Alexandr-Filatov/PSFB_PrimarySyde/BOM/PSFB_PrimarySide_BOM_08.06.2026_EN.xlsx

Reference | Value | Product Name | Replacement | Package | Description | Quantity | DNP
C5, C15, C24, C33, C40, C41, C42, C43, C44, C45, C46, C47, C48, C53 | 100n |  |  | SMD 0805 | Capacitor SMD 50V | 14
C14, C30 | 100n | C1812X104K102T |  | SMD 1812 | Capacitor Film | 2
C49 | 10u | CA45-A010K106T |  | CP EIA-3216-18 Kemet-A | Capacitor Tantalum SMD | 1
C50 | 10u |  |  | SMD 1206 | Capacitor SMD 50V | 1
C9, C10, C17, C18, C26, C27, C35, C36 | 10u |  |  | SMD 1210 | Capacitor SMD 50V | 8
C12, C19, C28, C37 | 22p |  |  | SMD 0805 | Capacitor SMD 50V | 4
C3 | 22u | CA45-A010K226T |  | CP EIA-3216-18 Kemet-A | Capacitor Tantalum SMD | 1
C1, C2, C4, C7, C13, C16, C22, C23, C25, C31, C32, C34 | 56p |  |  | SMD 0805 | Capacitor SMD 50V | 12
C6, C8 | 5u | B32774D8505K000 |  | Rect L31.5mm W15.0mm P27.50mm MKS4 | Capacitor Film | 2
C11, C20, C29, C38 | ~ |  |  | SMD 0805 | Capacitor SMD 50V | 4
D2 | ~ | K7805-500R3 |  | K78xx-500R3 ÕýÊä³ö | Linear regulator | 1
D10, D14, D18, D22 | ~ | US1M |  | SMA | Ultrafast diode | 4
D4, D23, D25, D27 | ~ | FYLS-0805UBC |  | SMD 0805 | LEDs | 4
D3, D6, D24, D26 | ~ | FYLS-0805URC |  | SMD 0805 | LEDs | 4
D5, D28 | ~ | FYLS-0805UYC |  | SMD 0805 | LEDs | 2
D32, D33, D34, D35 | ~ | MS2111 |  | SO-8 3.9x4.9mm P1.27mm | LVDS | 4
D8, D12, D16, D20 | ~ | MMSZ5240B |  | SOD-123 | Zener diode | 4
D9, D13, D17, D21 | ~ | BZT52C2V4S |  | SOD-323 | Zener diode | 4
D1 | ~ | 74HC21 |  | SOIC-14 3.9x8.7mm P1.27mm | AND | 1
D7, D11, D15, D19 | ~ | NSI6651ASC-DSWR |  | SOIC-16W 7.5x10.3mm P1.27mm | Gate Driver | 4
J10 | ~ | FH12-20S-0.5SH |  | Hirose FH12-20S-0.5SH 1x20-1MP P0.50mm | Connector | 1
J5, J6, J7, J8, J9, J12 | ~ | KLS1-208-2-04-S |  | PinSocket 2x02 P2.54mm | Connector | 6
Q5 | ~ | BC817 |  | SOT-23 | Bipolar transistor | 1
Q1, Q2, Q3, Q4 | ~ | C3M0065100K |  | TO-247-4 | SiC Mosfet | 4
R10, R14, R21, R28 | 10 |  |  | SMD 1206 | Resistor SMD | 4
R13, R16, R23, R30, R39, R40, R41, R42 | 100 |  |  | SMD 0805 | Resistor SMD | 8
R8, R17, R24, R31 | 10k |  |  | SMD 0805 | Resistor SMD | 4
R7, R12, R20, R27 | 120 |  |  | SMD 0805 | Resistor SMD | 4
R1, R2, R3, R4, R5, R9, R18, R19, R25, R26, R32, R33, R34, R35, R36, R37, R38, R101 | 1k |  |  | SMD 0805 | Resistor SMD | 18
R11, R15, R22, R29 | 2.2 |  |  | SMD 1206 | Resistor SMD | 4
R6 | 3k |  |  | SMD 0805 | Resistor SMD | 1
R100 | 4.7k |  |  | SMD 0805 | Resistor SMD | 1
U5 | ~ | AMS1117-3.3 |  | SOT-223-3 | Linear regulator | 1
U6, U7, U8, U9 | ~ | USBLC6-2SC6 |  | SOT-23-6 | ESD protection | 4
U1, U2, U3, U4 | ~ | 74LVC1G08 |  | SOT-353 SC-70-5 | AND | 4
