Alexandr-Filatov/PSFB_PrimarySyde/PSFB_Supply/BOM/PSFB_Supply_BOM_15.07.2026_EN.xlsx

Reference | Value | Product Name | Replacement | Package | Description | Quantity | DNP
C3, C8, C13, C18 | 100p |  |  | SMD 1206 | Capacitor SMD 50V | 4
C4, C5, C9, C10, C14, C15, C19, C20 | 10u |  |  | SMD 1206 | Capacitor SMD 50V | 8
C1, C2, C6, C7, C11, C12, C16, C17 | 4.7u |  |  | SMD 1206 | Capacitor SMD 50V | 8
D1, D2, D3, D4 | ~ | QA151C3 |  | QA01 | DC/DC | 4
J1, J2, J3, J4, J5, J6 | ~ | KLS1-207-2-04-S |  | PinHeader 2x02 P2.54mm | Connector | 6
L1, L2, L3, L4 | 22u | CDRH5D28NP-220NC |  | Bourns-SRN6028 | Inductor SMD | 4
