Alexandr-Filatov/PSFB_PrimarySyde/3D/PSFB_Primary_Syde_v1.0_light.step

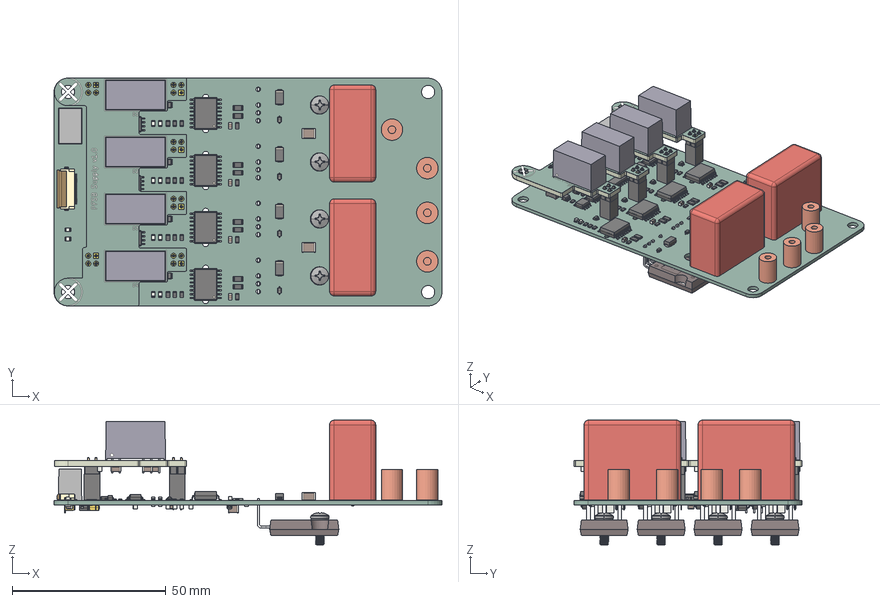
[picture p1: CAD file, 2026-08-03]
3D/PSFB_Primary_Syde_v1.0_light.step
126.0 x 74.0 x 40.5 mm
PinSocket_2x02_P2.54mm_Vertical x 6
C_0805_2012Metric x 30
R_0805_2012Metric x 36
LED_0805_2012Metric x 10
R_1206_3216Metric x 8
SOT-353_SC-70-5 x 4
D_SOD-323 x 4
K78-500-SHELL_3_1
PRT0001_1 x 3
SOT-23
PIN_1_1_1 x 20
PinHeader_2x02_P2.54mm_Vertical x 6
C_1206_3216Metric x 21
PSFB_Supply_copper
PSFB_Supply_silkscreen x 2
PSFB_Supply_soldermask x 2
PSFB_Supply_PCB
SOT-23-6 x 4
C_Rect_L31.5mm_W15.0mm_P27.50mm_MKS4 x 2
SO-8_3.9x4.9mm_P1.27mm x 4
D_SMA x 4
Bush_Phase x 4
SOIC-16W_7.5x10.3mm_P1.27mm x 4
C_1812_4532Metric x 2
SOIC-14_3.9x8.7mm_P1.27mm
lock
pins
D_SOD-123 x 4
C_1210_3225Metric x 8
CP_EIA-3216-18_Kemet-A x 2
SOT-223
PSFB_PrimarySide_PCB
