Alexandr-Filatov/PSFB_PrimarySyde/3D/Bush_Phase.stp

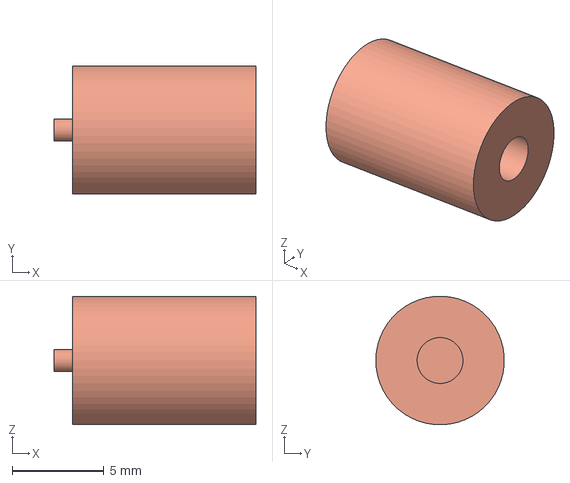
[picture p2: CAD file, 2026-08-03]
3D/Bush_Phase.stp
11.0 x 6.99 x 7.00 mm
