Alexandr-Filatov/PSFB_PrimarySyde/3D/PSFB_Supply_v1.0.step

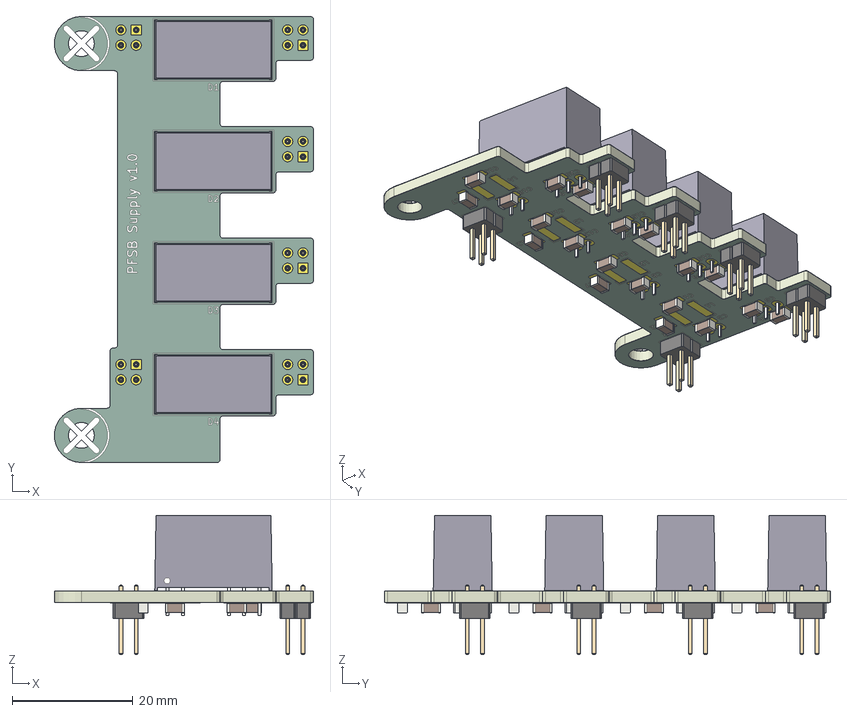
[picture p3: CAD file, 2026-05-29]
3D/PSFB_Supply_v1.0.step
43.0 x 74.0 x 23.1 mm
PIN_1_1_1 x 20
PinHeader_2x02_P2.54mm_Vertical x 6
C_1206_3216Metric x 20
PSFB_Supply_copper
PSFB_Supply_silkscreen x 2
PSFB_Supply_soldermask x 2
PSFB_Supply_PCB
