Alexandr-Filatov/PSFB_PrimarySyde/3D/1-215079-4.stp

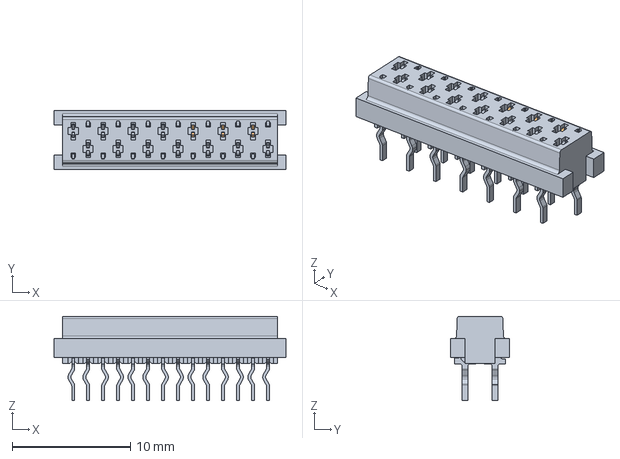
[picture p4: CAD file, 2026-05-27]
3D/1-215079-4.stp
19.7 x 5.00 x 7.15 mm
