Alexandr-Filatov/PSFB_PrimarySyde/3D/K78xx-1000R3.stp

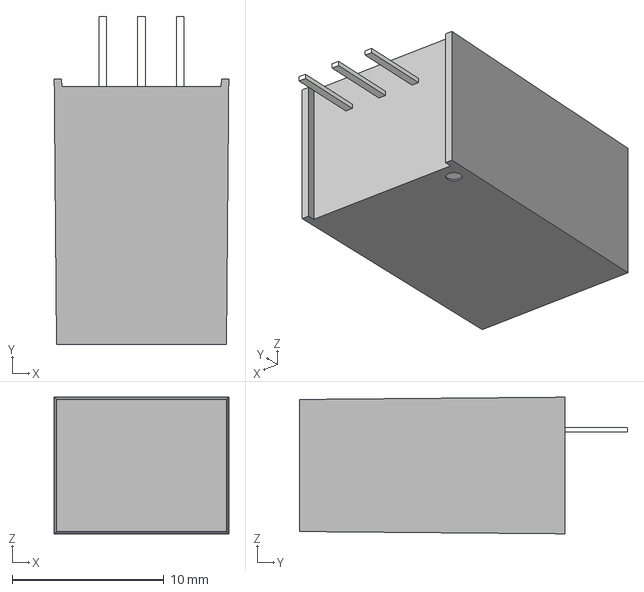
[picture p5: CAD file, 2026-05-27]
3D/K78xx-1000R3.stp
11.5 x 21.6 x 9.00 mm
K78-1000_1
PRT0001_1 x 3
