Alexandr-Filatov/PSFB_PrimarySyde/3D/QA01.stp

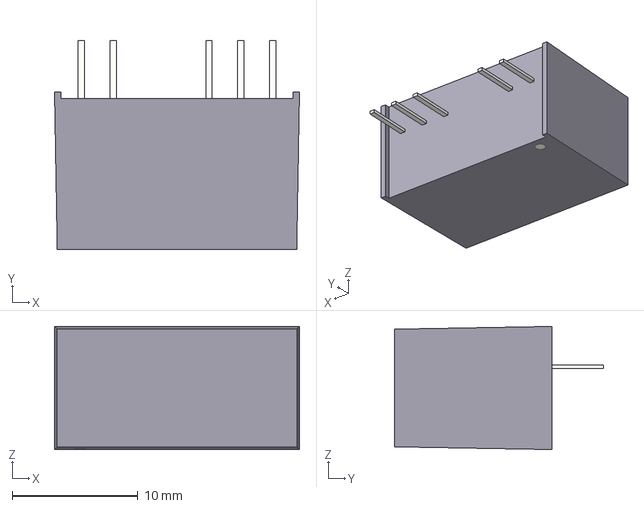
[picture p6: CAD file, 2026-05-25]
3D/QA01.stp
19.5 x 16.6 x 9.80 mm
PIN_1_1_1 x 5
