Alexandr-Filatov/PSFB_PrimarySyde/3D/70085998.stp

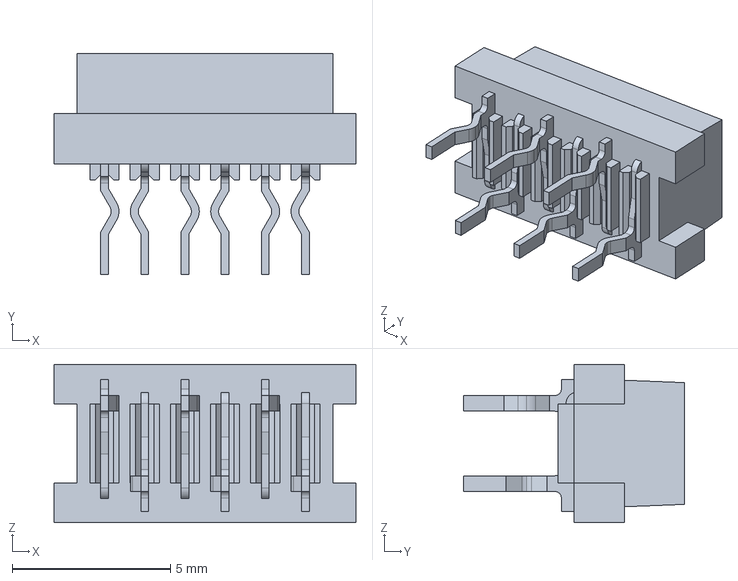
[picture p7: CAD file, 2026-05-27]
3D/70085998.stp
9.55 x 7.00 x 5.00 mm
