Alexandr-Filatov/PSFB_PrimarySyde/3D/TO-247-4LD bend top + M3 screw.stp

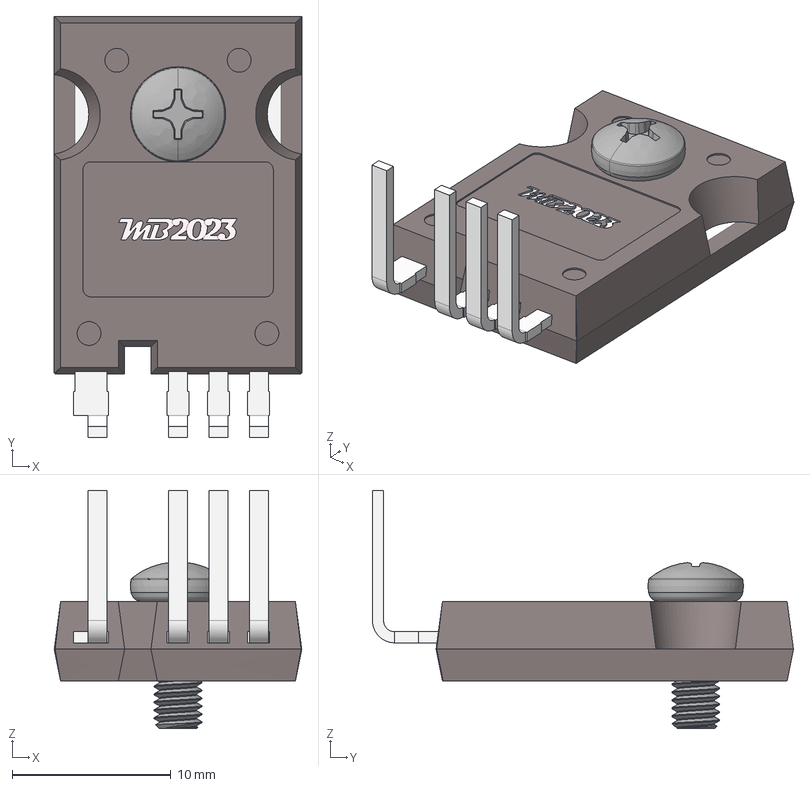
[picture p9: CAD file, 2026-05-26]
3D/TO-247-4LD bend top + M3 screw.stp
15.6 x 26.5 x 15.0 mm
