Alexandr-Filatov/PSFB_PrimarySyde/PSFB_PrimarySide.kicad_pcb

## KiCad design PSFB_PrimarySide.kicad_pcb (2026-08-03)

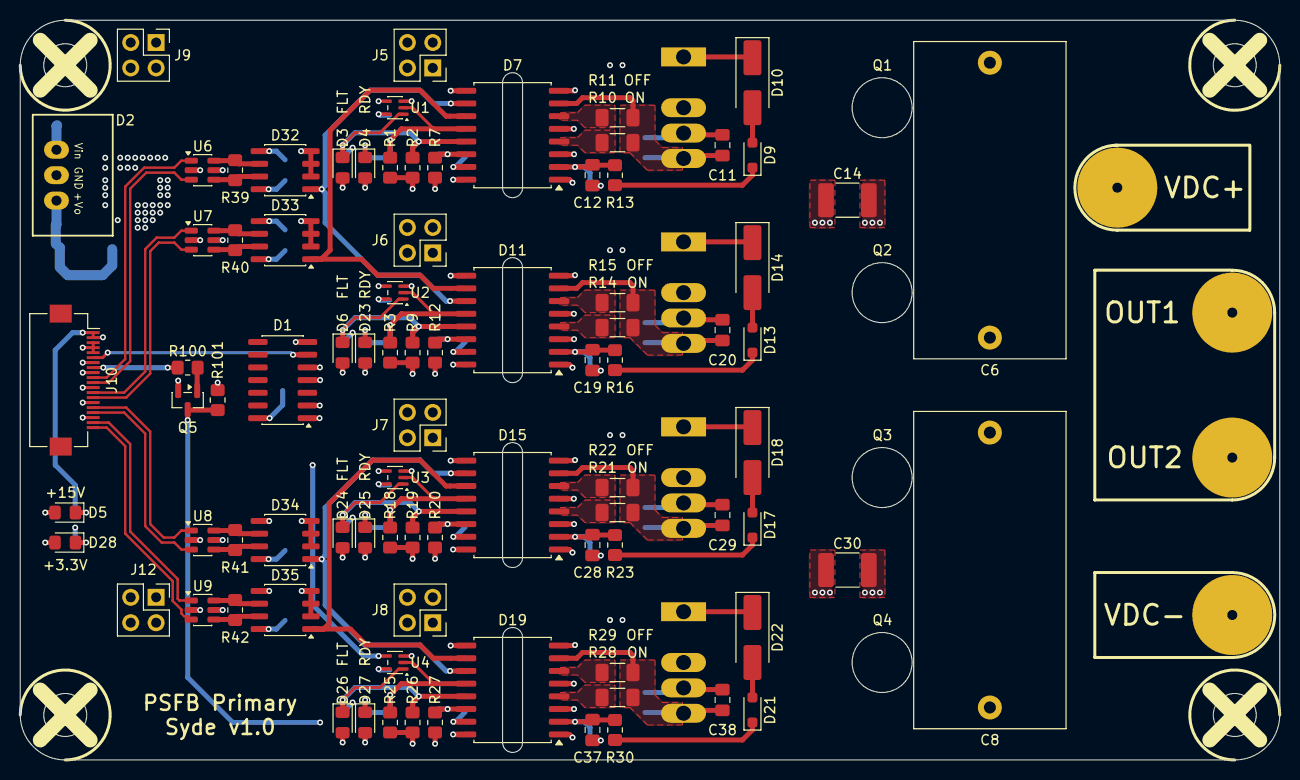
[picture p10: board PSFB_PrimarySide.kicad_pcb from above]

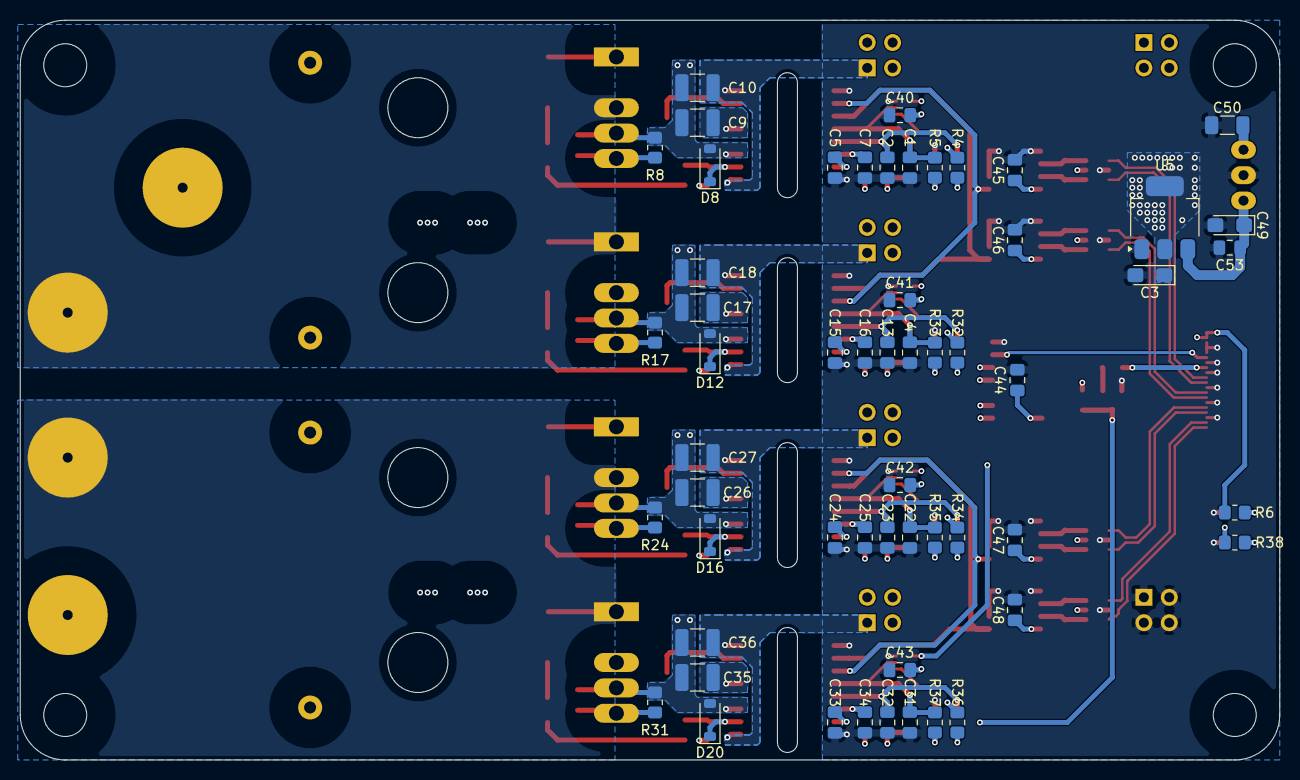
[picture p11: board PSFB_PrimarySide.kicad_pcb from below]

Board: 4 copper layers, 126.0 x 74.0 mm, 154 parts (56 on the bottom side), 90 nets.

Parts:
C1, C2, C4, C7, C13, C16, C22, C23, C25, C31, C32, C34: 56p; C_0805_2012Metric_Pad1.18x1.45mm_HandSolder
C3: 22u; CP_EIA-3216-18_Kemet-A_HandSolder
C5, C15, C24, C33, C40, C41, C42, C43, C44, C45, C46, C47, C48, C53: 100n; C_0805_2012Metric_Pad1.18x1.45mm_HandSolder
C6, C8: 5u; C_Rect_L31.5mm_W15.0mm_P27.50mm_MKS4
C9, C10, C17, C18, C26, C27, C35, C36: 10u; C_1210_3225Metric_Pad1.33x2.70mm_HandSolder
C11, C20, C29, C38: C_0805_2012Metric_Pad1.18x1.45mm_HandSolder
C12, C19, C28, C37: 22p; C_0805_2012Metric_Pad1.18x1.45mm_HandSolder
C14, C30: 100n; C_1812_4532Metric_Pad1.57x3.40mm_HandSolder
C49: 10u; CP_EIA-3216-18_Kemet-A_HandSolder
C50: 10u; C_1206_3216Metric_Pad1.33x1.80mm_HandSolder
D1: SOIC-14_3.9x8.7mm_P1.27mm
D2: K78xx-500R3 ÕýÊä³ö
D3, D4, D5, D6, D23, D24, D25, D26, D27, D28: LED_0805_2012Metric_Pad1.15x1.40mm_HandSolder
D7, D11, D15, D19: SOIC-16W_7.5x10.3mm_P1.27mm
D8, D12, D16, D20: D_SOD-123
D9, D13, D17, D21: D_SOD-323_HandSoldering
D10, D14, D18, D22: D_SMA_Handsoldering
D32, D33, D34, D35: SO-8_3.9x4.9mm_P1.27mm
H1, H2, H3, H4: MountingHole_4.3mm_M4
J1: DC+; Bush_1x8
J2: DC-; Bush_1x8
J3: OUT1; Bush_1x8
J4: OUT2; Bush_1x8
J5, J6, J7, J8, J9, J12: PinSocket_2x02_P2.54mm_Vertical
J10: Hirose_FH12-20S-0.5SH_1x20-1MP_P0.50mm_Horizontal
Q1, Q2, Q3, Q4: TO-247-4_Horizontal_TabDown
Q5: SOT-23
R1, R2, R3, R4, R5, R9, R18, R19, R25, R26, R32, R33, R34, R35, R36, R37, R38, R101: 1k; R_0805_2012Metric_Pad1.20x1.40mm_HandSolder
R6: 3k; R_0805_2012Metric_Pad1.20x1.40mm_HandSolder
R7, R12, R20, R27: 120; R_0805_2012Metric_Pad1.20x1.40mm_HandSolder
R8, R17, R24, R31: 10k; R_0805_2012Metric_Pad1.20x1.40mm_HandSolder
R10, R14, R21, R28: 10; R_1206_3216Metric_Pad1.30x1.75mm_HandSolder
R11, R15, R22, R29: 2.2; R_1206_3216Metric_Pad1.30x1.75mm_HandSolder
R13, R16, R23, R30, R39, R40, R41, R42: 100; R_0805_2012Metric_Pad1.20x1.40mm_HandSolder
R100: 4.7k; R_0805_2012Metric_Pad1.20x1.40mm_HandSolder
U1, U2, U3, U4: SOT-353_SC-70-5
U5: SOT-223-3_TabPin2
U6, U7, U8, U9: SOT-23-6

Connections:
+3.3V: C3.1, C5.2, C15.2, C24.2, C33.2, C40.2, C41.2, C42.2, C43.2, C44.2, C45.1, C46.1, C47.1, C48.1, D1.14 (Vcc), D7.15 (Vcc1), D11.15 (Vcc1), D15.15 (Vcc1), D19.15 (Vcc1), D32.8 (VCC), D33.8 (VCC), D34.8 (VCC), D35.8 (VCC), R1.2, R2.2, R3.2, R4.2, R9.2, R18.2, R19.2, R25.2, R26.2, R32.2, R34.2, R36.2, R38.2, R101.2, U1.5 (VCC), U2.5 (VCC), U3.5 (VCC), U4.5 (VCC), U5.2 (VO), U6.5 (VBUS), U7.5 (VBUS), U8.5 (VBUS), U9.5 (VBUS)
+15V: C50.1, D2.1 (Vin), J9.1, J9.2, J9.3, J9.4, J10.1, J10.2, R6.2
/+5V: C49.1, C53.1, D2.3 (+Vo), U5.3 (VI)
/Common_FLT1: D1.5 (1D), U1.4
/Common_FLT2: D1.4 (1C), U2.4
/Common_FLT3: D1.2 (1B), U3.4
/Common_FLT4: D1.1 (1A), U4.4
/Driver_1/+15V: C9.1, D7.5 (Vcc2), J5.2
/Driver_1/-4V: C10.2, D7.1 (Vee2), D7.8 (Vee2), J5.1
/Driver_1/GND2: C9.2, C10.1, C11.1, C12.2, D7.3 (GND2), D8.2 (A), D14.1 (K), J3.1 (Pin_1_1), J5.3, J5.4, Q1.2 (S), Q1.3 (DS), Q2.1 (D), R8.1
/Driver_1/RDY: C1.1, D7.12 (RDY), R1.1, R5.2, U1.2
/Driver_1/~FLT: C2.1, D3.1 (K), D7.13 (~FLT), R2.1, U1.1
/Driver_1/~RST: Q5.3 (C), R7.1, R12.1, R20.1, R27.1, R101.1
/Driver_2/+15V: C17.1, D11.5 (Vcc2), J6.2
/Driver_2/-4V: C18.2, D11.1 (Vee2), D11.8 (Vee2), J6.1
/Driver_2/RDY: C4.1, D11.12 (RDY), R3.1, R33.2, U2.2
/Driver_2/~FLT: C13.1, D6.1 (K), D11.13 (~FLT), R9.1, U2.1
/Driver_3/+15V: C26.1, D15.5 (Vcc2), J7.2
/Driver_3/-4V: C27.2, D15.1 (Vee2), D15.8 (Vee2), J7.1
/Driver_3/GND2: C26.2, C27.1, C28.2, C29.1, D15.3 (GND2), D16.2 (A), D22.1 (K), J4.1 (Pin_1_1), J7.3, J7.4, Q3.2 (S), Q3.3 (DS), Q4.1 (D), R24.1
/Driver_3/RDY: C22.1, D15.12 (RDY), R18.1, R35.2, U3.2
/Driver_3/~FLT: C23.1, D15.13 (~FLT), D24.1 (K), R19.1, U3.1
/Driver_4/+15V: C35.1, D19.5 (Vcc2), J8.2
/Driver_4/-4V: C36.2, D19.1 (Vee2), D19.8 (Vee2), J8.1
/Driver_4/RDY: C31.1, D19.12 (RDY), R25.1, R37.2, U4.2
/Driver_4/~FLT: C32.1, D19.13 (~FLT), D26.1 (K), R26.1, U4.1
/ERROR: D1.6 (1Y), J10.6
/PWM_H1: D7.10 (IN+), D11.11 (IN-), D32.1 (RO)
/PWM_H1_N: J10.11, U6.3 (I/O2)
/PWM_H1_P: J10.10, U6.1 (I/O1)
/PWM_H2: D15.10 (IN+), D19.11 (IN-), D34.1 (RO)
/PWM_H2_N: J10.17, U8.3 (I/O2)
/PWM_H2_P: J10.16, U8.1 (I/O1)
/PWM_L1: D7.11 (IN-), D11.10 (IN+), D33.1 (RO)
/PWM_L1_N: J10.14, U7.3 (I/O2)
/PWM_L1_P: J10.13, U7.1 (I/O1)
/PWM_L2: D15.11 (IN-), D19.10 (IN+), D35.1 (RO)
/PWM_L2_N: J10.20, U9.3 (I/O2)
/PWM_L2_P: J10.19, U9.1 (I/O1)
/RST: J10.8, R100.1
GND: C1.2, C2.2, C3.2, C4.2, C5.1, C7.1, C13.2, C15.1, C16.1, C22.2, C23.2, C24.1, C25.1, C31.2, C32.2, C33.1, C34.1, C40.1, C41.1, C42.1, C43.1, C44.1, C45.2, C46.2, C47.2, C48.2, C49.2, C50.2, C53.2, D1.7 (GND), D2.2 (GND), D4.1 (K), D5.1 (K), D7.9 (GND1), D7.16 (TEST), D11.9 (GND1), D11.16 (TEST), D15.9 (GND1), D15.16 (TEST), D19.9 (GND1), D19.16 (TEST), D23.1 (K), D25.1 (K), D27.1 (K), D28.1 (K), D32.2 (~RE), D32.3 (DE), D32.4 (DI), D32.5 (GND), D33.2 (~RE), D33.3 (DE), D33.4 (DI), D33.5 (GND), D34.2 (~RE), D34.3 (DE), D34.4 (DI), D34.5 (GND), D35.2 (~RE), D35.3 (DE), D35.4 (DI), D35.5 (GND), J10.3, J10.4, J10.5, J10.7, J10.9, J10.12, J10.15, J10.18, J12.1, J12.2, J12.3, J12.4, Q5.2 (E), U1.3 (GND), U2.3 (GND), U3.3 (GND), U4.3 (GND), U5.1 (GND), U6.2 (GND), U7.2 (GND), U8.2 (GND), U9.2 (GND)
GNDPWR: C6.2, C8.2, C14.2, C17.2, C18.1, C19.2, C20.1, C30.2, C35.2, C36.1, C37.2, C38.1, D11.3 (GND2), D12.2 (A), D19.3 (GND2), D20.2 (A), J2.1 (Pin_1_1), J6.3, J6.4, J8.3, J8.4, Q2.2 (S), Q2.3 (DS), Q4.2 (S), Q4.3 (DS), R17.1, R31.1
unnamed: D3.2 (A), R4.1
unnamed: D4.2 (A), R5.1
unnamed: D5.2 (A), R6.1
unnamed: D6.2 (A), R32.1
unnamed: C11.2, D7.7 (CLAMP), Q1.4 (G), R8.2, R10.1, R11.2
unnamed: C12.1, D7.2 (DESAT), D8.1 (K), R13.2
unnamed: D7.4 (OUTH), R10.2
unnamed: D7.6 (OUTL), R11.1
unnamed: C7.2, D7.14 (~RST), R7.2
unnamed: D9.1 (K), R13.1
unnamed: D9.2 (A), D10.2 (A)
unnamed: C20.2, D11.7 (CLAMP), Q2.4 (G), R14.1, R15.2, R17.2
unnamed: C19.1, D11.2 (DESAT), D12.1 (K), R16.2
unnamed: D11.4 (OUTH), R14.2
unnamed: D11.6 (OUTL), R15.1
unnamed: C16.2, D11.14 (~RST), R12.2
unnamed: D13.2 (A), D14.2 (A)
unnamed: D13.1 (K), R16.1
unnamed: C29.2, D15.7 (CLAMP), Q3.4 (G), R21.1, R22.2, R24.2
unnamed: C28.1, D15.2 (DESAT), D16.1 (K), R23.2
unnamed: D15.4 (OUTH), R21.2
unnamed: D15.6 (OUTL), R22.1
unnamed: C25.2, D15.14 (~RST), R20.2
unnamed: D17.2 (A), D18.2 (A)
unnamed: D17.1 (K), R23.1
unnamed: C38.2, D19.7 (CLAMP), Q4.4 (G), R28.1, R29.2, R31.2
unnamed: C37.1, D19.2 (DESAT), D20.1 (K), R30.2
unnamed: D19.4 (OUTH), R28.2
unnamed: D19.6 (OUTL), R29.1
unnamed: C34.2, D19.14 (~RST), R27.2
unnamed: D21.2 (A), D22.2 (A)
unnamed: D21.1 (K), R30.1
unnamed: D23.2 (A), R33.1
unnamed: D24.2 (A), R34.1
unnamed: D25.2 (A), R35.1
unnamed: D26.2 (A), R36.1
unnamed: D27.2 (A), R37.1
unnamed: D28.2 (A), R38.1
unnamed: D32.6 (A), R39.2, U6.6 (I/O1)
unnamed: D32.7 (B), R39.1, U6.4 (I/O2)
unnamed: D33.6 (A), R40.2, U7.6 (I/O1)
unnamed: D33.7 (B), R40.1, U7.4 (I/O2)
unnamed: D34.6 (A), R41.2, U8.6 (I/O1)
unnamed: D34.7 (B), R41.1, U8.4 (I/O2)
unnamed: D35.6 (A), R42.2, U9.6 (I/O1)
unnamed: D35.7 (B), R42.1, U9.4 (I/O2)
unnamed: Q5.1 (B), R100.2
VDC: C6.1, C8.1, C14.1, C30.1, D10.1 (K), D18.1 (K), J1.1 (Pin_1_1), Q1.1 (D), Q3.1 (D)
