Alexandr-Filatov/PSFB_PrimarySyde/PSFB_Supply/PSFB_Supply.kicad_pcb

## KiCad design PSFB_Supply/PSFB_Supply.kicad_pcb (2026-07-22)

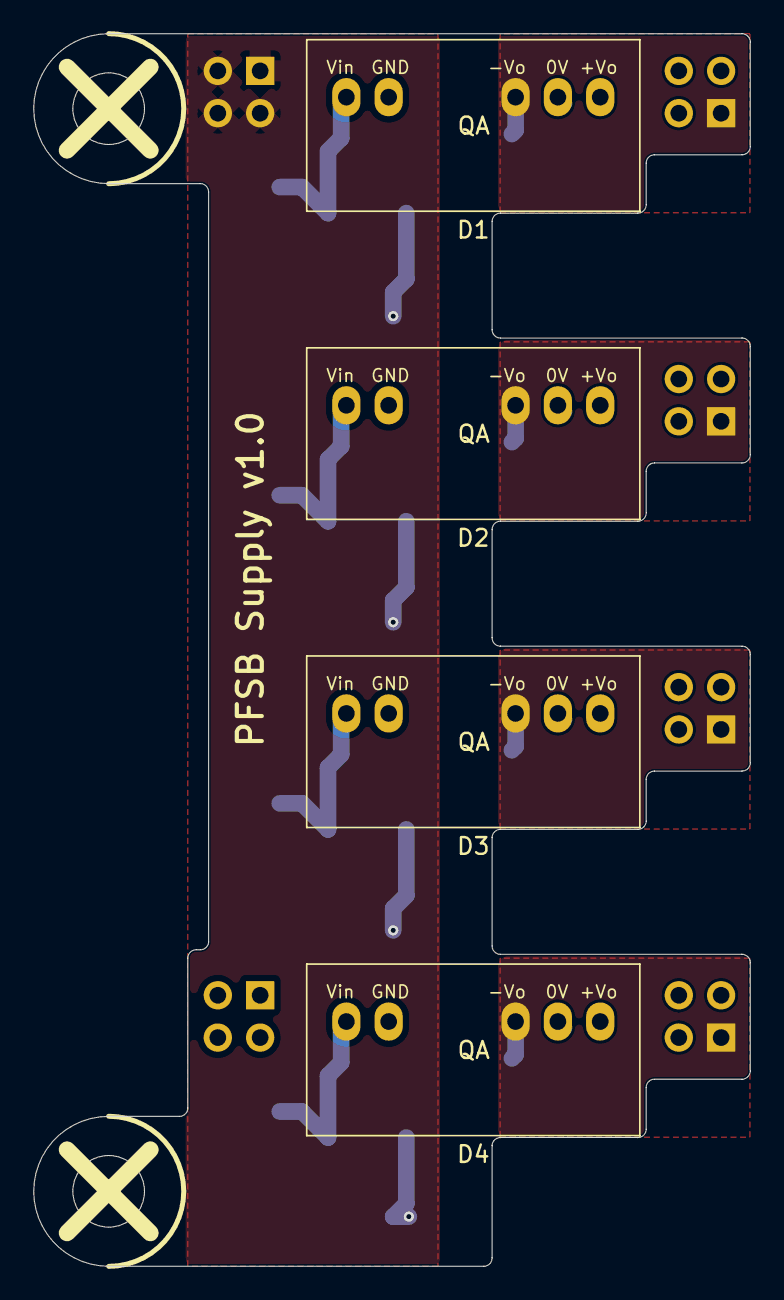
[picture p12: board PSFB_Supply.kicad_pcb from above]

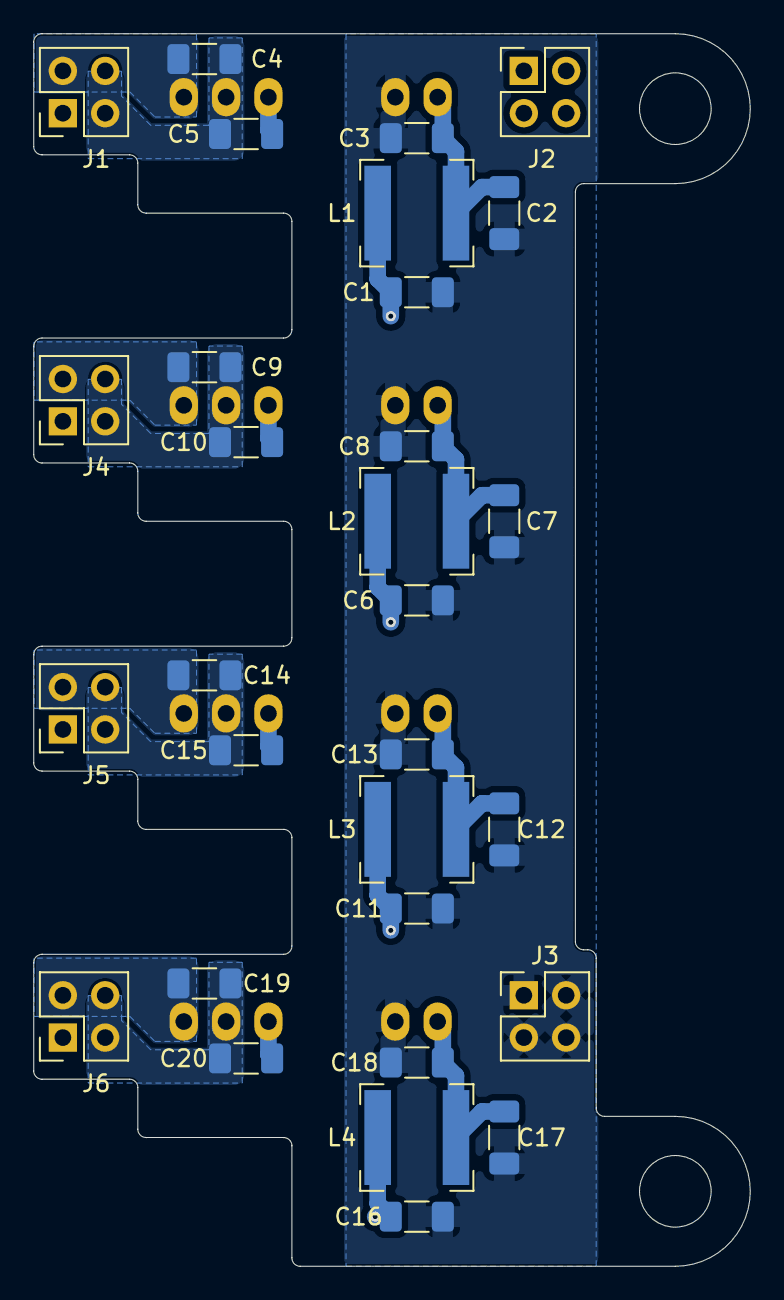
[picture p13: board PSFB_Supply.kicad_pcb from below]

Board: 2 copper layers, 43.0 x 74.0 mm, 36 parts (30 on the bottom side), 18 nets.

Parts:
C1, C2, C6, C7, C11, C12, C16, C17: 4.7u; C_1206_3216Metric_Pad1.33x1.80mm_HandSolder
C3, C8, C13, C18: 100p; C_1206_3216Metric_Pad1.33x1.80mm_HandSolder
C4, C5, C9, C10, C14, C15, C19, C20: 10u; C_1206_3216Metric_Pad1.33x1.80mm_HandSolder
D1, D2, D3, D4: QA01
H3, H4: MountingHole; MountingHole_4.3mm_M4
J1, J2, J3, J4, J5, J6: PinHeader_2x02_P2.54mm_Vertical
L1, L2, L3, L4: 22u; L_Bourns-SRN6028

Connections:
+15V: C1.1, C6.1, C11.1, C16.1, J2.1, J2.2, J2.3, J2.4, L1.1, L2.1, L3.1, L4.1
/QA01_1/+15V_OUT: C4.1, D1.7 (+Vo), J1.2
/QA01_1/-4V_OUT: C5.2, D1.5 (-Vo), J1.1
/QA01_1/GND2: C4.2, C5.1, D1.6 (0V), J1.3, J1.4
/QA01_2/+15V_OUT: C9.1, D2.7 (+Vo), J4.2
/QA01_2/-4V_OUT: C10.2, D2.5 (-Vo), J4.1
/QA01_2/GND2: C9.2, C10.1, D2.6 (0V), J4.3, J4.4
/QA01_3/+15V_OUT: C14.1, D3.7 (+Vo), J5.2
/QA01_3/-4V_OUT: C15.2, D3.5 (-Vo), J5.1
/QA01_3/GND2: C14.2, C15.1, D3.6 (0V), J5.3, J5.4
/QA01_4/+15V_OUT: C19.1, D4.7 (+Vo), J6.2
/QA01_4/-4V_OUT: C20.2, D4.5 (-Vo), J6.1
/QA01_4/GND2: C19.2, C20.1, D4.6 (0V), J6.3, J6.4
GND: C1.2, C2.2, C3.2, C6.2, C7.2, C8.2, C11.2, C12.2, C13.2, C16.2, C17.2, C18.2, D1.2 (GND), D2.2 (GND), D3.2 (GND), D4.2 (GND), J3.1, J3.2, J3.3, J3.4
unnamed: C2.1, C3.1, D1.1 (Vin), L1.2
unnamed: C7.1, C8.1, D2.1 (Vin), L2.2
unnamed: C12.1, C13.1, D3.1 (Vin), L3.2
unnamed: C17.1, C18.1, D4.1 (Vin), L4.2
