Alexandr-Filatov/PSFB_PrimarySyde/(commit log)

2026-05-25 zero commit
    [Driver.kicad_sch, PSFB_PrimarySide.kicad_pcb, PSFB_PrimarySide.kicad_sch, QA01.stp]
2026-05-25 VER1.0: убрал источники с платы
    [Driver.kicad_sch, PSFB_PrimarySide.kicad_pcb]
2026-05-25 VER1.0: добавил разъемы питания
    [Driver.kicad_sch, PSFB_PrimarySide.kicad_pcb]
2026-05-26 VER1.0: развел 4 канала
    [Driver.kicad_sch, LVDS.kicad_sch, PSFB_PrimarySide.kicad_pcb, PSFB_PrimarySide.kicad_sch, TO-247-4LD bend bottom + M3 screw.stp, TO-247-4LD bend top + M3 screw.stp]
2026-05-27 VER1.0: добавил разъем под FFC
    [1-215079-4.stp, 70085998.stp, Driver.kicad_sch, K78xx-1000R3.stp, K78xx-500R3.stp, LVDS.kicad_sch, PSFB_PrimarySide.kicad_pcb, PSFB_PrimarySide.kicad_sch]
2026-05-29 VER1.0: добавил плату питания драйверов и развел всю силовую плату
    [PSFB_PrimarySide.kicad_pcb, PSFB_PrimarySide.kicad_sch, PSFB_Supply.kicad_pcb, PSFB_Supply.kicad_sch, PSFB_Supply_v1.0.step, QA01.kicad_sch]
2026-06-02 VER1.0: добавил ресет общий
    [Driver.kicad_sch, PSFB_PrimarySide.kicad_pcb, PSFB_PrimarySide.kicad_sch, PSFB_PrimarySide_BOM_01.06.2026.xlsx]
2026-06-08 VER1.0: сделал файлы для производства
    [Driver.kicad_sch, LVDS.kicad_sch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]
2026-07-22 VER1.0: добавил интерактивный BOM
    [PSFB_Supply-B_Cu.gbr, PSFB_Supply-B_Mask.gbr, PSFB_Supply-B_Silkscreen.gbr, PSFB_Supply-Edge_Cuts.gbr, PSFB_Supply-F_Cu.gbr, PSFB_Supply-F_Mask.gbr, PSFB_Supply-F_Silkscreen.gbr, PSFB_Supply-NPTH.drl]
2026-08-03 VER1.0: обновил 3D сборки
    [Bush_Phase.stp, PSFB_PrimarySide.kicad_pcb, PSFB_Primary_Syde_v1.0_light.step]
